kurdish-yoda/LoopPedal/LoopPedalPCB/looppedal.kicad_pcb

## KiCad design LoopPedalPCB/looppedal.kicad_pcb (2020-04-27)

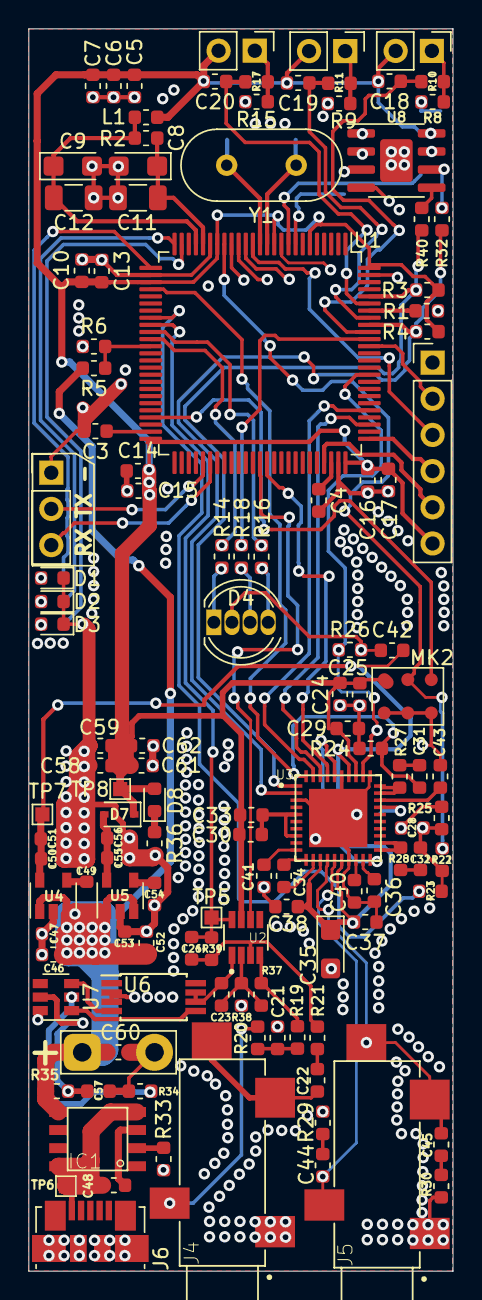
[picture p1: board looppedal.kicad_pcb from above]

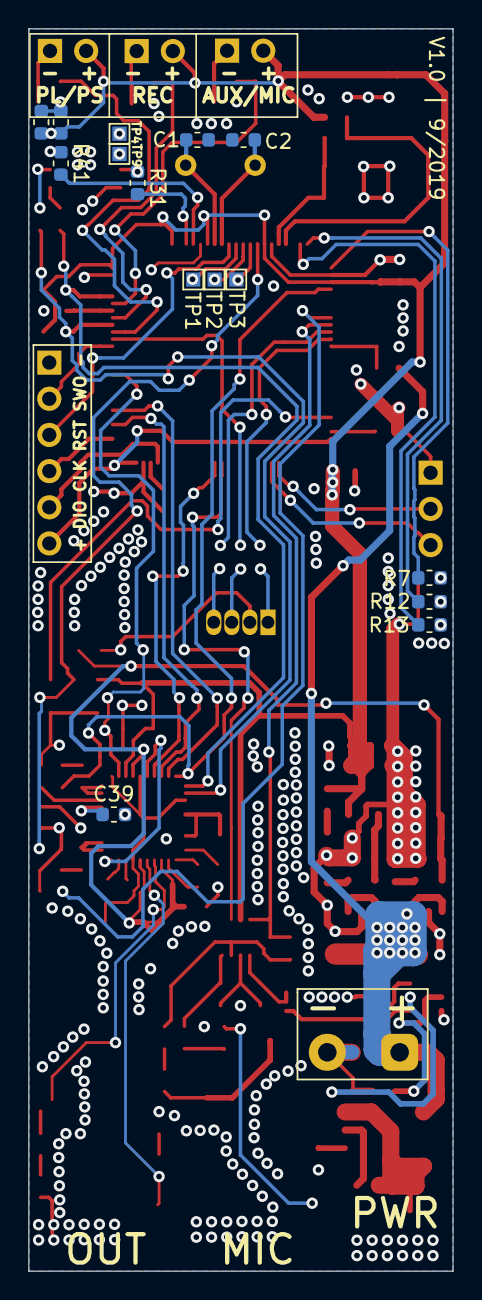
[picture p2: board looppedal.kicad_pcb from below]

Board: 2 copper layers, 29.8 x 87.2 mm, 140 parts (15 on the bottom side), 94 nets.

Parts:
+: Battery; TestPoint_2Pads_Pitch5.08mm_Drill1.3mm
C1, C2: 20pF; C_0603_1608Metric
C3, C4: 2.2uF; C_0603_1608Metric
C5, C6, C7, C10, C13, C14, C15, C16, C18, C19, C20, C24, C27, C28, C47, C51, C53, C56, C58, C59, C61, C62, C63: 100nF; C_0603_1608Metric
C8, C9: 1uF; CP_EIA-3216-12_Kemet-S
C11, C12: 100nF; C_1206_3216Metric
C17, C30, C31, C32, C33, C34, C36, C40, C41, C46, C50, C52, C55: 1uF; C_0603_1608Metric
C21, C25, C60: 10uF; C_0603_1608Metric
C22, C29, C37, C38, C42: 0.1uF; C_0603_1608Metric
C23: 0.01uF; C_0603_1608Metric
C26: 47pF; C_0603_1608Metric
C35: CP; CP_EIA-3216-12_Kemet-S
C39, C43: 150pF; C_0603_1608Metric
C44, C45: 0.022uF; C_0603_1608Metric
C48, C57: 0.1uF/25V; C_0603_1608Metric
C49, C54: 10nF; C_0603_1608Metric
D1, D2, D3, D8: LED; LED_0603_1608Metric
D4: LED_RCBG; LED_D5.0mm-4_RGB
D7: D_Schottky_ALT; D_SOD-323
IC1: TP4056; SOP-8
J1: SW_PLAY_PAUSE; PinHeader_1x02_P2.54mm_Vertical
J2: SW_REC; PinHeader_1x02_P2.54mm_Vertical
J3: SW_AUX_MIC; PinHeader_1x02_P2.54mm_Vertical
J4, J5: SJ-3524-SMT-PI; CUI_SJ-3524-SMT-PI
J6: USB_B_Micro; USB_Micro-B_Molex_47346-0001
J8: Conn_01x06; PinHeader_1x06_P2.54mm_Vertical
J9: DBG; PinHeader_1x03_P2.54mm_Vertical
L1: fcm; L_0603_1608Metric
MK2: MP45DT02; ST_HLGA-6_3.76x4.72mm_P1.65mm
R1, R6: 510; R_0603_1608Metric
R2: 47; R_0603_1608Metric
R3, R4: 4.7k; R_0603_1608Metric
R5: 10k; R_0603_1608Metric
R7, R12, R13, R14, R16, R18, R19, R31, R34, R36, R41: 1K; R_0603_1608Metric
R8, R9, R15, R24, R25, R37, R38: 100K; R_0603_1608Metric
R10, R11, R17, R26: 10K; R_0603_1608Metric
R20: 2K2; R_0603_1608Metric
R21: 20K; R_0603_1608Metric
R22, R33: 1.2K; R_0603_1608Metric
R23, R32, R40: 0; R_0603_1608Metric
R27, R28, R35: 100; R_0603_1608Metric
R29, R30: 51; R_0603_1608Metric
R39: 200K; R_0603_1608Metric
TP1, TP2, TP3, TP4, TP5, TP6, TP7, TP8, TP9: TestPoint; TestPoint_Pad_1.0x1.0mm
U1: STM32F407VGTx; LQFP-100_14x14mm_P0.5mm
U2: MAX4468EKAT; SOT65P280X145-8N
U3: CS43L22-CNZ; QFN50P600X600X100-41N
U4: LD3985M25R_SOT23; SOT-23-5
U5: LD3985M33R_SOT23; SOT-23-5
U6: FS8205; TSSOP-8_4.4x3mm_P0.65mm
U7: DW01; SOT-23-6
U8: M24M02-DRMN6TP; SOIC-8-1EP_3.9x4.9mm_P1.27mm_EP2.29x3mm
Y1: 8MHz; Crystal_HC49-U_Vertical

Connections:
+2V5: C35.1, C37.2, C38.2, C42.2, C50.1, C51.1, TP7.1, U3.13, U3.16, U3.34, U4.5
-BATT: +.2, C1.2, C2.2, C3.2, C4.2, C5.1, C6.1, C7.1, C8.2, C9.2, C10.1, C11.1, C12.2, C13.1, C14.1, C15.1, C16.1, C17.1, C21.1, C23.2, C24.2, C25.2, C27.1, C28.1, C29.1, C35.2, C36.2, C37.1, C38.1, C39.2, C40.2, C41.2, C42.1, C43.2, C46.2, C47.2, C48.2, C49.2, C50.2, C51.2, C52.2, C53.2, C54.2, C55.2, C56.2, C57.1, C58.2, C59.2, C60.2, C61.2, C62.2, C63.1, D1.1, D2.1, D3.1, D4.2, IC1.1, IC1.3, J4.1, J5.1, J6.5, J6.6, J8.1, J9.1, MK2.1, MK2.2, MK2.3, R1.2, R6.1, R8.1, R9.1, R15.1, R24.1, R25.2, R26.2, R29.1, R30.1, R33.1, R34.2, R36.2, R38.1, U1.10, U1.20, U1.27, U1.74, U1.99, U2.1, U3.3, U3.17, U3.31, U3.35, U3.41, U4.2, U5.2, U6.2, U6.3, U6.6, U6.7, U7.6, U8.4, U8.9
BAT_VCC: +.1, C46.1, C47.1, C52.1, C53.1, C60.1, IC1.5, R5.2, R35.1, U4.1, U4.3, U5.1, U5.3
CHRG_0: R7.2, U1.26
CHRG_1: R12.2, U1.25
CHRG_2: R13.2, U1.24
MCU_NRST: J8.3, U1.14
MCU_VBAT: C5.2, C6.2, C7.2, C10.2, C13.2, C14.2, C15.2, C16.2, C17.2, C18.2, C19.2, C20.2, C24.1, C25.1, C27.2, C29.2, C30.1, C33.1, C58.1, C59.1, C61.1, C62.1, C63.2, D7.1, D8.2, J1.2, J2.2, J3.2, J8.6, L1.1, MK2.6, R3.2, R4.2, TP8.1, U1.6, U1.11, U1.19, U1.28, U1.50, U1.75, U1.100, U2.7, U3.33, U8.8
MCU_VDDA: C9.1, C12.1, L1.2, R2.2, U1.22
MCU_VREF+: C8.1, C11.2, R2.1, U1.21
unnamed: C1.1, U1.12, Y1.1
unnamed: C2.1, U1.13, Y1.2
unnamed: C3.1, U1.49
unnamed: C4.1, U1.73
unnamed: C21.2, R19.1, R20.2
unnamed: C22.1, R21.1
unnamed: C22.2, J4.2, J4.4
unnamed: C23.1, R37.1, R38.2, U2.2
unnamed: C26.2, R21.2, R39.1, U2.3
unnamed: C28.2, C32.1, R22.2, R23.2, R25.1
unnamed: C30.2, C33.2, U3.5, U3.8
unnamed: C31.2, R27.2
unnamed: C32.2, R28.2
unnamed: C34.1, U3.12
unnamed: C34.2, U3.11
unnamed: C36.1, U3.19
unnamed: C39.1, U3.27
unnamed: C40.1, U3.18
unnamed: C41.1, U3.10
unnamed: C43.1, U3.28
unnamed: C44.1, J5.3, U3.15
unnamed: C44.2, R29.2
unnamed: C45.1, J5.2, J5.4, U3.14
unnamed: C45.2, R30.2
unnamed: C48.1, IC1.4, IC1.8, J6.1, TP6.1
unnamed: C49.1, U4.4
unnamed: C54.1, U5.4
unnamed: C55.1, C56.1, D7.2, U5.5
unnamed: C57.2, R35.2, U7.5
unnamed: D1.2, R7.1
unnamed: D2.2, R12.1
unnamed: D3.2, R13.1
unnamed: D4.1, R14.2
unnamed: D4.3, R18.2
unnamed: D4.4, R16.2
unnamed: D8.1, R36.1
unnamed: IC1.2, R33.2
unnamed: J1.1, R8.2, R10.2
unnamed: J2.1, R9.2, R11.2
unnamed: J3.1, R15.2, R17.2
unnamed: J4.3, R20.1
unnamed: R1.1, U1.94
unnamed: R19.2, R37.2, U2.4
unnamed: R27.1, U3.29, U3.30
unnamed: R28.1, U3.21, U3.22
unnamed: R31.2, U8.3
unnamed: R32.1, U8.6
unnamed: R34.1, U7.2
unnamed: R40.1, U8.5
unnamed: R41.1, U8.7
unnamed: TP1.1, U1.15
unnamed: TP2.1, U1.16
unnamed: TP3.1, U1.17
unnamed: TP4.1, U8.1
unnamed: TP9.1, U8.2
unnamed: U3.20, U3.36
unnamed: U6.4, U7.3
unnamed: U6.5, U7.1
PA4: C31.1, R24.2, U1.29, U3.40
PA13: J8.5, U1.72
PA14: J8.4, U1.76
PB2: R5.1, R6.2, U1.37
PB3: J8.2, U1.89
PB6: R4.1, R32.2, U1.92, U3.2
PB9: R3.1, R40.2, U1.96, U3.1
PB10: MK2.4, U1.47
PC3: MK2.5, R22.1, U1.18
PC4: R23.1, U1.33
PC5: C26.1, R39.2, TP5.1, U1.34, U2.8
PC6: U1.63, U2.6
PC7: U1.64, U3.37
PC10: U1.78, U3.38
PC12: U1.80, U3.39
PC14: R31.1, U1.8
PC15: R41.2, U1.9
PD4: R26.1, U1.85, U3.32
STATUS_0: R14.1, U1.36
STATUS_1: R16.1, U1.35
STATUS_2: R18.1, U1.90
SW_AUXMIC: C20.1, R17.1, U1.95
SW_PLAY_PAUSE: C18.1, R10.1, U1.91
SW_REC: C19.1, R11.1, U1.93
UART3_RX: J9.3, U1.56
UART3_TX: J9.2, U1.55
